kekenbuangjog-cell/ResQplug/(commit log)

2026-09-17 feat: add dual USB/BT transport firmware and Firebase device audit tracking
2026-09-26 feat(mesh): implement autonomous LoRa beacons, multi-hop relaying, and hybrid hardware bridge
    - Add
    autonomous periodic LoRa discovery beacons (25s ± 3s jitter) in ESP32 firmware
    - Implement autonomous store-and-forward packet relay with circular deduplication cache (max 3 hops)
    - Create ResQPlugHardwareBridge singleton for seamless Bluetooth/USB session handover to Dashboard
    - Fix Bluetooth presence bug in DashboardActivity to enable heartbeat syncing to Firestore
    - Add dynamic contact and chat link badges (Direct 1-Hop RSSI, Multi-Hop Relay, Cloud Link)
    - Preserve local offline LoRa messages during Firestore snapshots
2026-10-10 feat(lora): two-node link and phone end-to-end proven; add Ra-02 bring-up kits
    Verified on real hardware: phone -> Bluetooth -> Node 1 -> 433 MHz -> Node 2.
    - t08_two_node_link: new test, first proven packet between two ESP32s.
    T8 PASS both directions, 6/6 packets, 0 drops, RSSI -66 dBm / SNR +9.5 dB.
    - unified_node0.2: real 8-slot TX queue replacing the discarding
    [ACK:TX_QUEUED_SIMULATED]; pinMode for external LED (GPIO 4 was dead);
    non-blocking mesh relay replacing delay(random(100,300)); RELAY_SKIP logging.
    - RA02_BRINGUP_NODE2/: full bring-up record for Ra-02 #2. Test E, T3, T6,
    T7, T8, U1, U2 all PASS.
    - RA02_BRINGUP/: Test E evidence plus T8 and E2E results for Ra-02 #1.
    - Pi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
2026-10-10 docs(app): add APP_RESTRUCTURE plan for MVP refactor
    Planning folder for rearranging the Android app into layer-based MVP
    (model/ view/ presenter/) per EXTERNAL_LED_FIREBASE_MVP_ACTIVITY_GUIDE.md.
    - README.md: decisions table and ground rules
    - PLAN.md: architecture decisions and phase rationale
    - TASKS.md: 8 phases, ~50 tasks, each with a verify step
    - MIGRATION_MAP.md: all 32 files, old path to new path, with line counts
    Baseline recorded: 32 files, 5359 lines, versionCode 1, commit b19928c.
    activity7/ (12 files, 1562 lines) is scheduled for deletion in Phase 3.
    Bluetooth confirmed as primary transport; USB-OTG stub to be made honest
    in Phase 2.5-2.6.
    No application code is changed by t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
